ELEC-291-2026/Project2.0/(list of files, cad)

Other CAD files:
FINAL WORKING BUILD FROM OWENS COMPUTER/stm32flash/BO230/BO230.obj
