ELEC-291-2026/Project2.0/schematic.pdf

# DETAILED SCHEMATICS

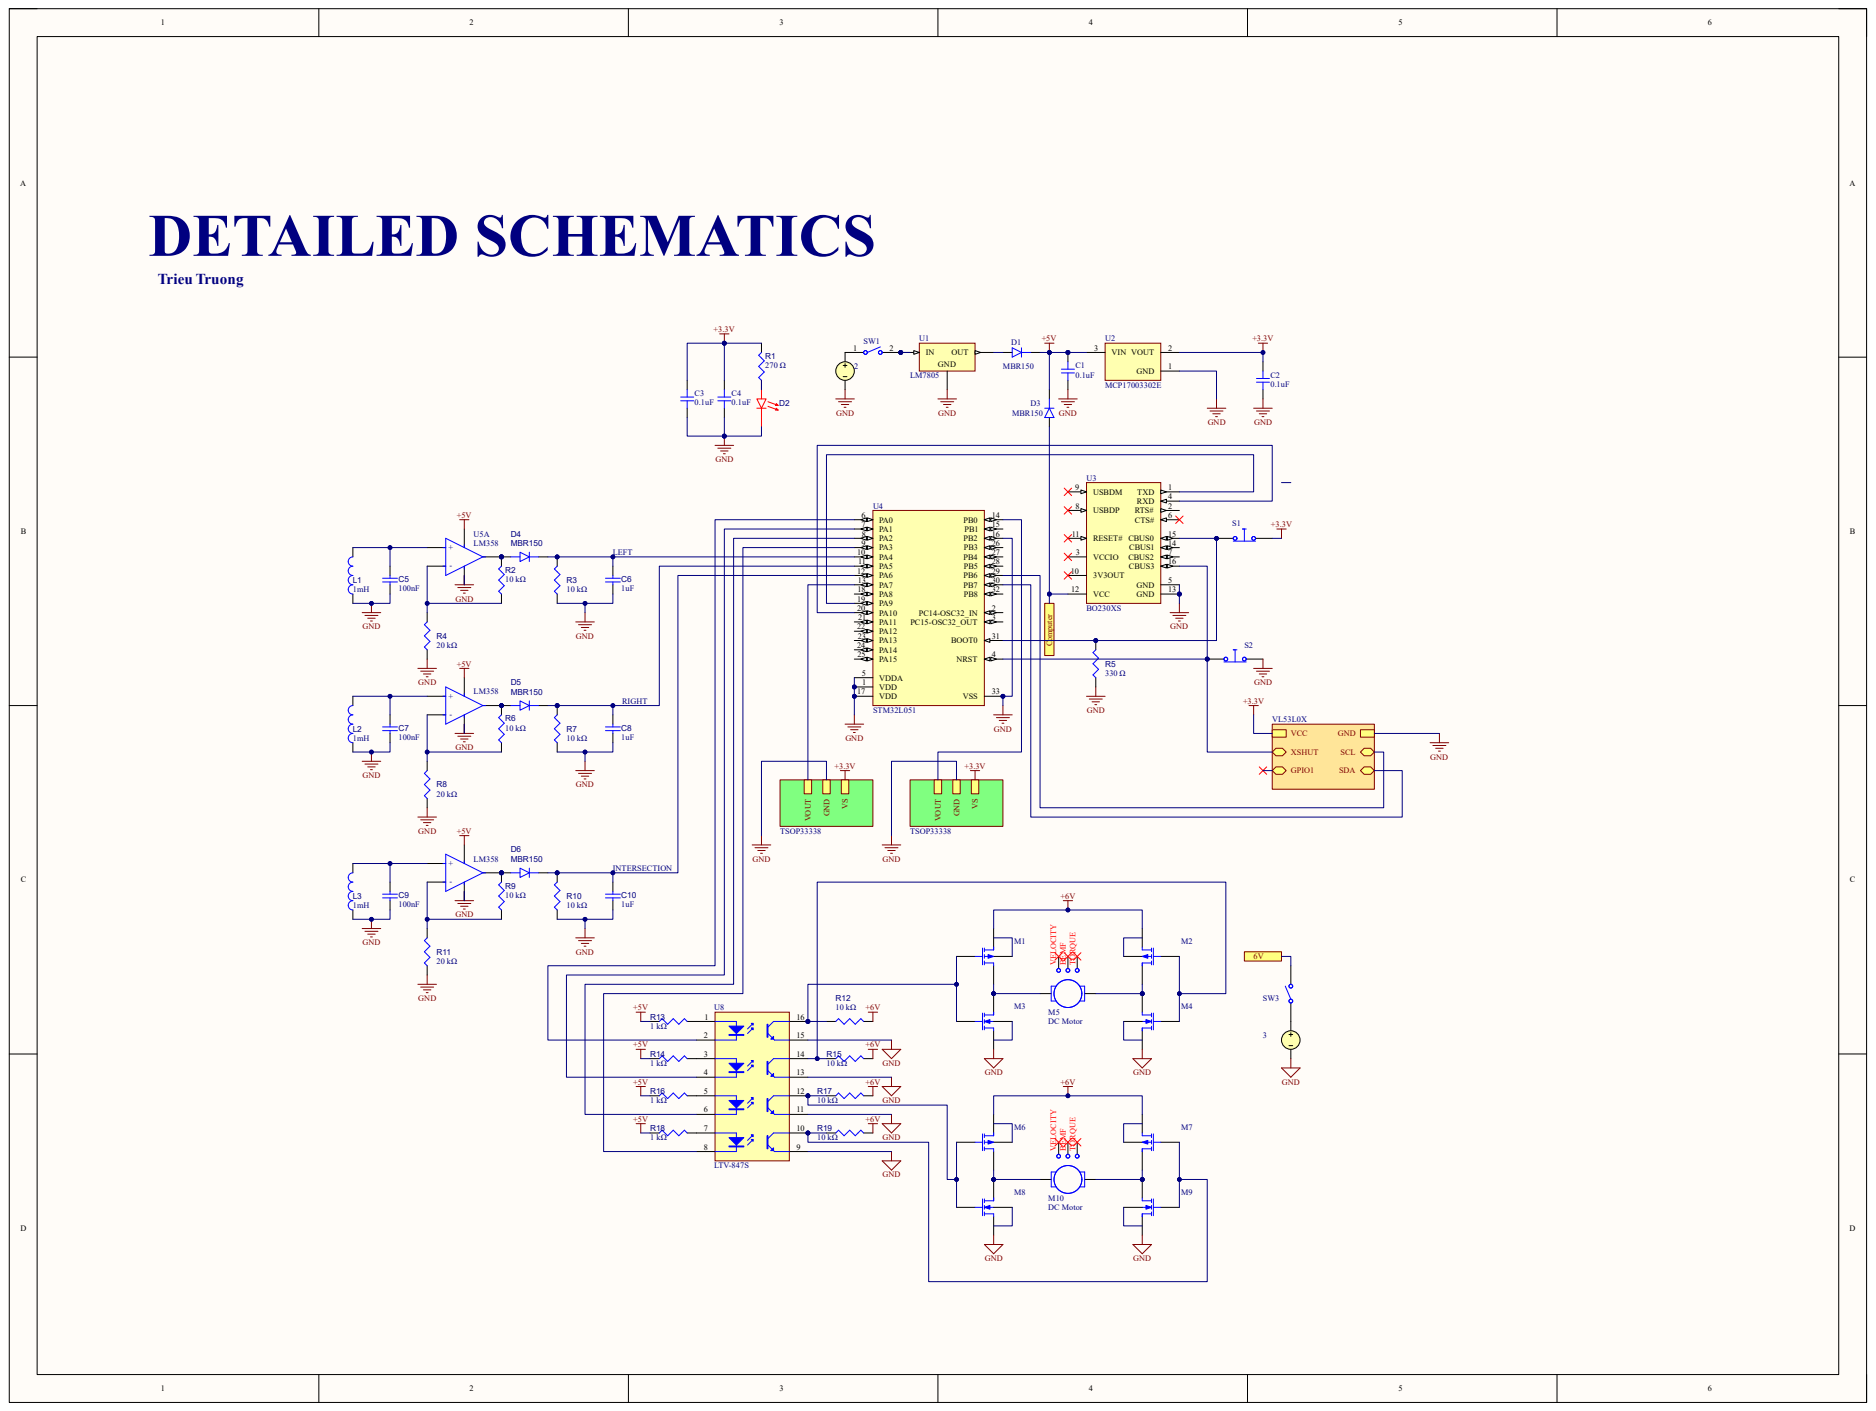
[picture p1: page 1]

GND VS GND VOUT

# H-BRIDGE

# Trieu Truong

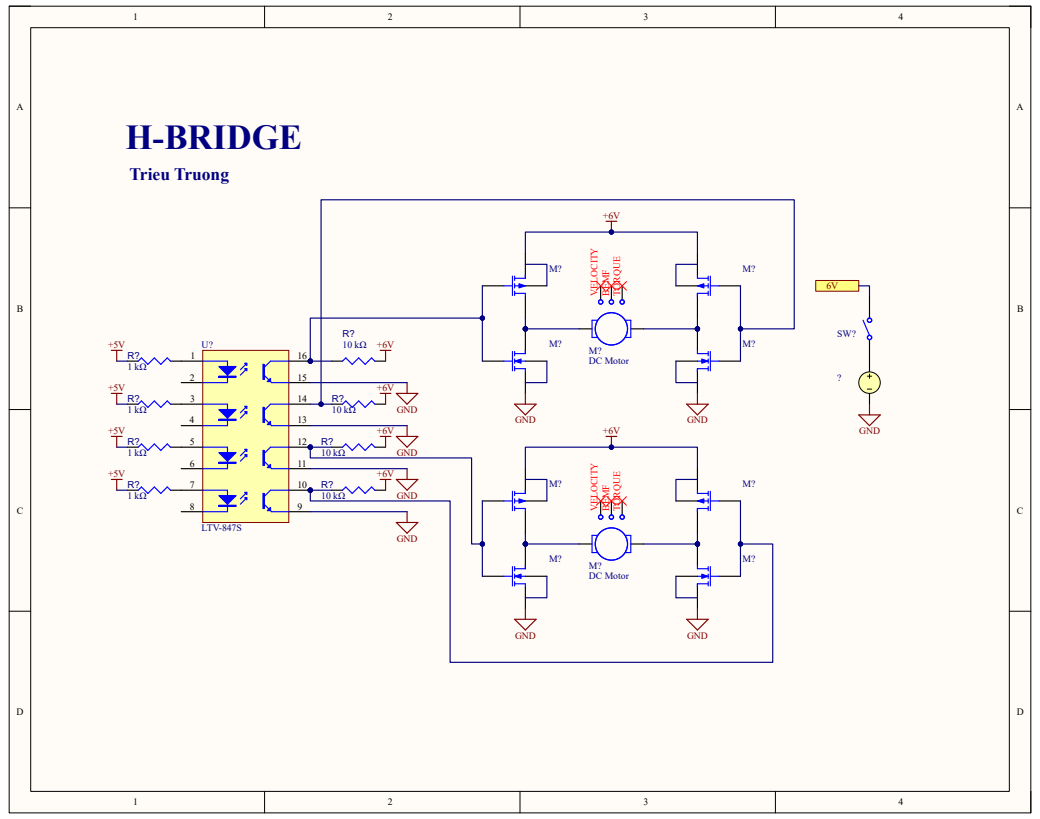
[picture p2: page 2]
LTV-847S; M? DC Motor; GND

M? VELOCITY BEMF TORQUE

# FIELD DETECTOR

# Trieu Truong

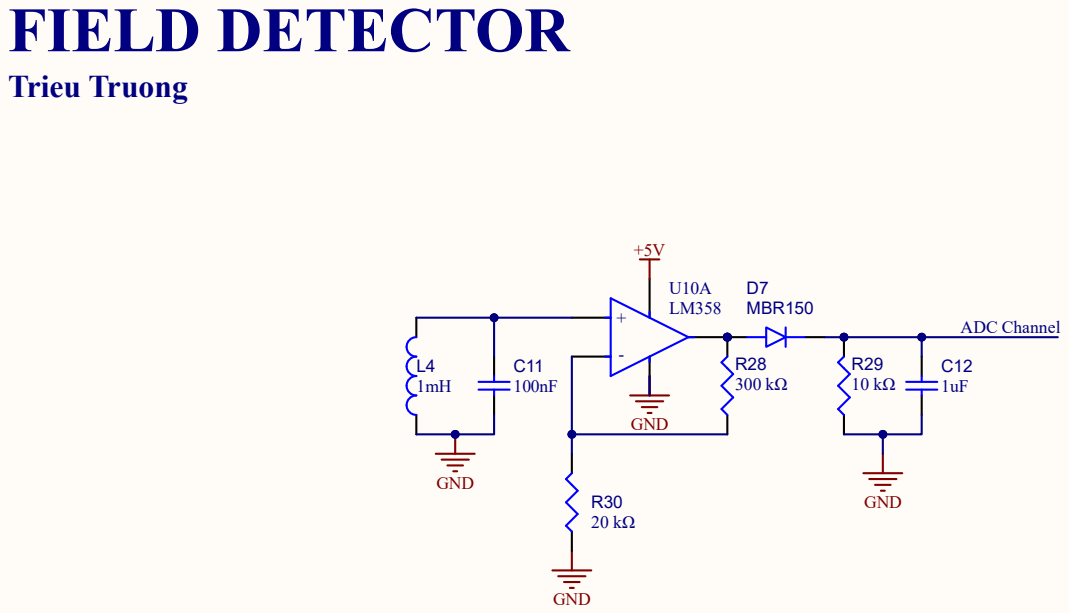
[picture p3: page 3]

# OBSTACLE DETECTOR

# Trieu Truong

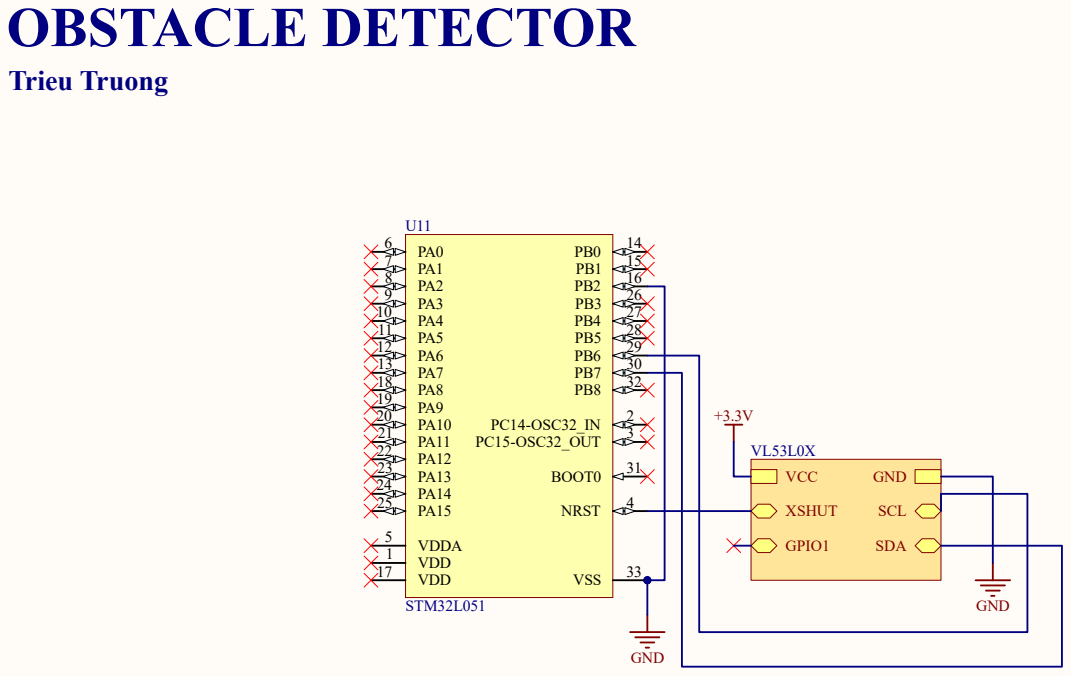
[picture p4: page 4]
VDD 1; VDD 17; PC14-OSC32_IN; PC15-OSC32_OUT; BOOT0; VSS; NRST; VDDA 5; STM32L051; GND; SCL; SDA; VCC; XSHUT; GPIO1

# CONTROLLER

# Trieu Truong

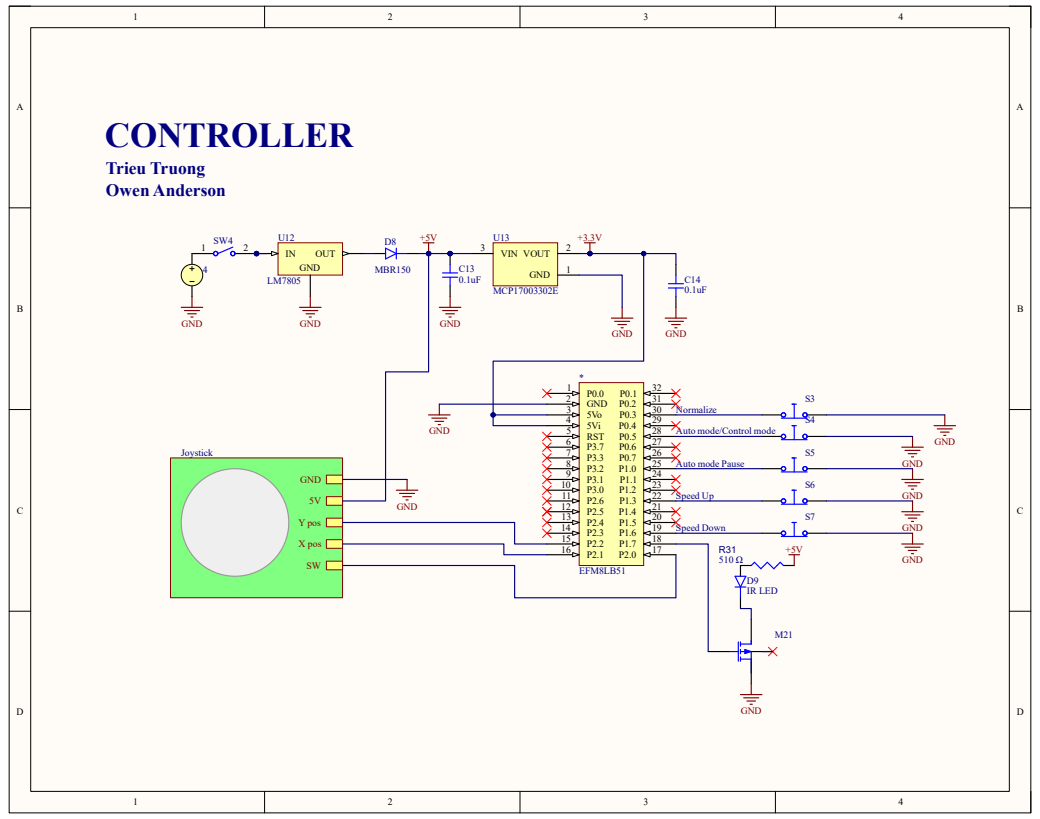
[picture p5: page 5]

Auto mode/Control mode
