ELEC-291-2026/Project2.0/FINAL WORKING BUILD FROM OWENS COMPUTER/main.c

#include "stm32l051xx.h"
#include "robot_auto_mode.h"
#include "collision_detector.h"

#define ADC_CH_LEFT         5
#define ADC_CH_RIGHT        4
#define ADC_CH_INTERSECT    6

int BASE_SPEED = 700;
#define TURN_SPEED          300
#define MAX_PWM             1000
#define KP                  2
#define KD                  3
#define DEADBAND            20

#define ENTRY_SIGNAL        200
#define EXIT_SIGNAL         100
#define INTERSECT_ENTRY     9999
#define INTERSECT_EXIT      100
#define TRACK_ACQUIRE_COUNT 3
#define SEARCH_SLOW_SPEED   200
#define SEARCH_FAST_SPEED   320
#define MIN_FORWARD_SPEED   150
#define MAX_FORWARD_SPEED   480
#define MAX_CORRECTION      160

#define F_CPU 32000000UL

#define LEFT_MOTOR_SIGN     -1
#define RIGHT_MOTOR_SIGN    -1
#define LEFT_MOTOR_TRIM_PCT  125  /* boost left motor by 20% to compensate for weakness */
#define MOTOR_OUTPUT_ACTIVE_LOW 1

#define SOFTWARE_PWM_TICK_HZ 100000UL
#define PWM_PERIOD_COUNTS   1000U

#define LED_SENSOR ((GPIOB->IDR >> 1) & 1U)
#define LED_SENSOR_2 (GPIOB->IDR & 1U)
#define STATUS_LED_GPIO_PORT GPIOA
#define STATUS_LED_PIN       (1U << 8U)

#define LED1_PA15_PIN  (1U << 15U)
#define LED2_PB3_PIN   (1U << 3U)



// LQFP32 pinout
//             ----------
//       VDD -|1       32|- VSS
//      PC14 -|2       31|- BOOT0
//      PC15 -|3       30|- PB7
//      NRST -|4       29|- PB6
//      VDDA -|5       28|- PB5
//       PA0 -|6       27|- PB4
//       PA1 -|7       26|- PB3
//       PA2 -|8       25|- PA15
//       PA3 -|9       24|- PA14
//       PA4 -|10      23|- PA13
//       PA5 -|11      22|- PA12
//       PA6 -|12      21|- PA11
//       PA7 -|13      20|- PA10 (Reserved for RXD)
//       PB0 -|14      19|- PA9  (Reserved for TXD)
//       PB1 -|15      18|- PA8  (LED+1k)
//       VSS -|16      17|- VDD
//             ----------

static int g_last_left_command;
static int g_last_right_command;
static volatile unsigned int g_motor_compare[4];
static volatile unsigned int g_pwm_counter;


static void set_motor_pin(unsigned int bit_mask, int active)
{
#if MOTOR_OUTPUT_ACTIVE_LOW
    if (active)
    {
        GPIOA->ODR &= ~bit_mask;
    }
    else
    {
        GPIOA->ODR |= bit_mask;
    }
#else
    if (active)
    {
        GPIOA->ODR |= bit_mask;
    }
    else
    {
        GPIOA->ODR &= ~bit_mask;
    }
#endif
}

// Add these globals near your other motor globals
static volatile unsigned int g_speaker_toggle_counts = 0;  // half-period in PWM ticks
static volatile unsigned int g_speaker_remaining = 0;       // ticks left to beep
static volatile unsigned int g_speaker_counter = 0;         // counts up to toggle

void speaker_beep(unsigned int frequency_hz, unsigned int duration_ms)
{
    // TIM2 fires at SOFTWARE_PWM_TICK_HZ (100,000 Hz)
    // half-period = ticks per half cycle = 100000 / (2 * freq)
    g_speaker_counter = 0;
    g_speaker_remaining = (SOFTWARE_PWM_TICK_HZ * duration_ms) / 1000U;
    g_speaker_toggle_counts = SOFTWARE_PWM_TICK_HZ / (2U * frequency_hz);
}

void wait_1us(void)
{
    // For SysTick info check the STM32L0xxx Cortex-M0 programming manual
    // Load for 1 microsecond: (SYSCLK_HZ / 1,000,000) - 1
    // At 32MHz, this puts 31 into the LOAD register (32 ticks total)
    SysTick->LOAD = (F_CPU / 1000000UL) - 1UL;  
    SysTick->VAL = 0; 
    SysTick->CTRL = SysTick_CTRL_CLKSOURCE_Msk | SysTick_CTRL_ENABLE_Msk; 
    
    // Wait for the COUNTFLAG (Bit 16) to be set
    while((SysTick->CTRL & SysTick_CTRL_COUNTFLAG_Msk) == 0); 
    
    SysTick->CTRL = 0; // Disable Systick counter
}

void wait_1ms(void)
{
    SysTick->LOAD = (F_CPU / 1000UL) - 1UL;
    SysTick->VAL = 0;
    SysTick->CTRL = 0x5;

    while ((SysTick->CTRL & (1U << 16U)) == 0U)
    {
    }

    SysTick->CTRL = 0;
}

void delayms(unsigned int ms)
{
    while (ms-- > 0U)
    {
        wait_1ms();
    }
}

static void clock_init(void)
{
    RCC->CR |= (1U << 0U);
    while ((RCC->CR & (1U << 2U)) == 0U)
    {
    }

    RCC->CFGR &= ~((0xFUL << 18U) | (0x3U << 22U) | (1U << 16U));
    RCC->CFGR |= (0x1U << 18U) | (0x1U << 22U);

    RCC->CR |= (1U << 24U);
    while ((RCC->CR & (1U << 25U)) == 0U)
    {
    }

    FLASH->ACR |= (1U << 0U);

    RCC->CFGR = (RCC->CFGR & ~0x3U) | 0x3U;
    while ((RCC->CFGR & (0x3U << 2U)) != (0x3U << 2U))
    {
    }
}

static void uart_init(void)
{
    RCC->IOPENR |= (1U << 0U);
    RCC->IOPENR |= (1U << 1U);
    RCC->APB2ENR |= (1U << 14U);

    GPIOA->MODER &= ~(3U << 18U);
    GPIOA->MODER |= (2U << 18U);
    GPIOA->AFR[1] &= ~(0xFU << 4U);
    GPIOA->AFR[1] |= (4U << 4U);

        

    USART1->BRR = 278U;
    USART1->CR1 = (1U << 3U) | (1U << 0U);
}

static void uart_putc(char c)
{
    while ((USART1->ISR & (1U << 7U)) == 0U)
    {
    }

    USART1->TDR = (unsigned char)c;
}

static void uart_puts(const char *s)
{
    while (*s != '\0')
    {
        uart_putc(*s);
        ++s;
    }
}

static void uart_print_int(int val, int width)
{
    char buf[12];
    int len;
    unsigned int uval;

    len = 0;

    if (val < 0)
    {
        uart_putc('-');
        uval = (unsigned int)(-val);
        --width;
    }
    else
    {
        uval = (unsigned int)val;
    }

    if (uval == 0U)
    {
        buf[len++] = '0';
    }
    else
    {
        while (uval > 0U)
        {
            buf[len++] = (char)('0' + (uval % 10U));
            uval /= 10U;
        }
    }

    while (len < width)
    {
        uart_putc(' ');
        --width;
    }

    while (len > 0)
    {
        uart_putc(buf[--len]);
    }
}

static void pwm_init(void)
{
    RCC->IOPENR |= (1U << 0U);
    RCC->APB1ENR |= (1U << 0U);

    GPIOA->MODER &= ~(GPIO_MODER_MODE0 |
        GPIO_MODER_MODE1 |
        GPIO_MODER_MODE2 |
        GPIO_MODER_MODE3);
    GPIOA->MODER |= GPIO_MODER_MODE0_0 |
        GPIO_MODER_MODE1_0 |
        GPIO_MODER_MODE2_0 |
        GPIO_MODER_MODE3_0;

    GPIOA->OTYPER &= ~(BIT0 | BIT1 | BIT2 | BIT3);
    GPIOA->OSPEEDR |= GPIO_OSPEEDER_OSPEED0 |
        GPIO_OSPEEDER_OSPEED1 |
        GPIO_OSPEEDER_OSPEED2 |
        GPIO_OSPEEDER_OSPEED3;
    GPIOA->PUPDR &= ~(GPIO_PUPDR_PUPD0 |
        GPIO_PUPDR_PUPD1 |
        GPIO_PUPDR_PUPD2 |
        GPIO_PUPDR_PUPD3);
        
        
     
	
	
#if MOTOR_OUTPUT_ACTIVE_LOW
    GPIOA->ODR |= BIT0 | BIT1 | BIT2 | BIT3;
#else
    GPIOA->ODR &= ~(BIT0 | BIT1 | BIT2 | BIT3);
#endif

    g_motor_compare[0] = 0U;
    g_motor_compare[1] = 0U;
    g_motor_compare[2] = 0U;
    g_motor_compare[3] = 0U;
    g_pwm_counter = 0U;

    TIM2->PSC = 0U;
    TIM2->ARR = (F_CPU / SOFTWARE_PWM_TICK_HZ) - 1U;
    TIM2->SR = 0U;
    TIM2->DIER = TIM_DIER_UIE;
    TIM2->CR1 = TIM_CR1_ARPE;
    TIM2->EGR = 1U;
    NVIC->ISER[0] |= BIT15;
    TIM2->CR1 |= TIM_CR1_CEN;
    __enable_irq();
}

static unsigned int clamp_command(int command)
{
    unsigned int magnitude;

    if (command < 0)
    {
        magnitude = (unsigned int)(-command);
    }
    else
    {
        magnitude = (unsigned int)command;
    }

    if (magnitude > (unsigned int)MAX_PWM)
    {
        magnitude = (unsigned int)MAX_PWM;
    }

    return magnitude;
}

static unsigned int command_to_compare(int command)
{
    unsigned int compare;
    unsigned int magnitude;

    magnitude = clamp_command(command);
    compare = (magnitude * PWM_PERIOD_COUNTS) / (unsigned int)MAX_PWM;

    if (compare >= PWM_PERIOD_COUNTS)
    {
        compare = PWM_PERIOD_COUNTS - 1U;
    }

    return compare;
}

static void motors_stop(void)
{
    g_motor_compare[0] = 0U;
    g_motor_compare[1] = 0U;
    g_motor_compare[2] = 0U;
    g_motor_compare[3] = 0U;
    set_motor_pin(BIT0, 0);
    set_motor_pin(BIT1, 0);
    set_motor_pin(BIT2, 0);
    set_motor_pin(BIT3, 0);
    g_last_left_command = 0;
    g_last_right_command = 0;
}

static void motors_set(int left, int right)
{
    g_last_left_command = left;
    g_last_right_command = right;

    left = left * LEFT_MOTOR_TRIM_PCT / 100;
    left *= LEFT_MOTOR_SIGN;
    right *= RIGHT_MOTOR_SIGN;

    g_motor_compare[0] = 0U;
    g_motor_compare[1] = 0U;
    g_motor_compare[2] = 0U;
    g_motor_compare[3] = 0U;

    if (left > 0)
    {
        g_motor_compare[0] = command_to_compare(left);
    }
    else if (left < 0)
    {
        g_motor_compare[1] = command_to_compare(left);
    }

    if (right > 0)
    {
        g_motor_compare[2] = command_to_compare(right);
    }
    else if (right < 0)
    {
        g_motor_compare[3] = command_to_compare(right);
    }
}

void TIM2_Handler(void)
{
    TIM2->SR &= ~TIM_SR_UIF;

    set_motor_pin(BIT0, g_motor_compare[0] > g_pwm_counter);
    set_motor_pin(BIT1, g_motor_compare[1] > g_pwm_counter);
    set_motor_pin(BIT2, g_motor_compare[2] > g_pwm_counter);
    set_motor_pin(BIT3, g_motor_compare[3] > g_pwm_counter);

    ++g_pwm_counter;
    if (g_pwm_counter >= PWM_PERIOD_COUNTS)
    {
        g_pwm_counter = 0U;
    }

    // Speaker tone generation
    if (g_speaker_remaining > 0U)
    {
        ++g_speaker_counter;
        if (g_speaker_counter >= g_speaker_toggle_counts)
        {
            GPIOA->ODR ^= (1U << 14); 
            g_speaker_counter = 0U;
        }
        --g_speaker_remaining;
    }
    else
    {
        GPIOA->ODR &= ~(1U << 14);
    }
}


static void adc_init(void)
{
    RCC->IOPENR |= (1U << 0U);
    RCC->APB2ENR |= (1U << 9U);

    GPIOA->MODER |= (3U << 8U) | (3U << 10U) | (3U << 12U);

    ADC1->CFGR2 |= (1U << 30U);

    if ((ADC1->CR & (1U << 0U)) != 0U)
    {
        ADC1->CR |= (1U << 1U);
        while ((ADC1->CR & (1U << 0U)) != 0U)
        {
        }
    }

    ADC1->CR |= (1U << 28U);
    delayms(1U);

    ADC1->CR |= (1U << 31U);
    while ((ADC1->CR & (1U << 31U)) != 0U)
    {
    }

    ADC1->SMPR = 0x5U;
    ADC1->CFGR1 = 0U;
    ADC1->CR |= (1U << 0U);
    while ((ADC1->ISR & (1U << 0U)) == 0U)
    {
    }
}

static int adc_read(int channel)
{
    int sum;
    int i;

    sum = 0;
    ADC1->CHSELR = (1U << channel);

    for (i = 0; i < 4; ++i)
    {
        ADC1->CR |= (1U << 2U);
        while ((ADC1->ISR & (1U << 2U)) == 0U)
        {
        }
        sum += (int)(ADC1->DR & 0xFFFU);
    }

    return sum / 4;
}

static const char *movement_name(int left, int right)
{
    if (left == 0 && right == 0)
    {
        return "STOP";
    }

    if (left > 0 && right > 0)
    {
        if (left == right)
        {
            return "FORWARD";
        }

        if (left > right)
        {
            return "VEER_RIGHT";
        }

        return "VEER_LEFT";
    }

    if (left < 0 && right < 0)
    {
        if (left == right)
        {
            return "REVERSE";
        }

        if (left < right)
        {
            return "REV_RIGHT";
        }

        return "REV_LEFT";
    }

    if (left < 0 && right > 0)
    {
        return "TURN_LEFT";
    }

    if (left > 0 && right < 0)
    {
        return "TURN_RIGHT";
    }

    if (left == 0)
    {
        if (right > 0)
        {
            return "PIVOT_LEFT";
        }

        return "PIVOT_RIGHT";
    }

    if (left > 0)
    {
        return "ARC_RIGHT";
    }

    return "ARC_LEFT";
}

static void control(int x, int y)
{
	//we convert to new system where left is controlled by x+y, and right by x-y
	int scaled_x = x*999/1000/2;
	int scaled_y = y*999/1000;
	
	int left = (scaled_y+scaled_x);
	int right = (scaled_y-scaled_x);
	
	motors_set(left, right);
}

static void timer22_init(void)
{
    RCC->APB2ENR |= RCC_APB2ENR_TIM22EN; // Enable TIM22 clock
    
    TIM22->PSC = 31;                     // Prescaler: 32MHz / (31 + 1) = 1MHz
    TIM22->ARR = 0xFFFF;                 // Auto-reload to max (16-bit)
    TIM22->CR1 &= ~TIM_CR1_CEN;          // Keep it off until needed
}

/* Bridge called by robot_auto_mode.c to drive the physical motors. */
void hbridge_motor_apply(const motor_command_t *command)
{
    motors_set(command->left_command, command->right_command);
}

static void led_flash(unsigned int pin_bit, unsigned int times)
{
    unsigned int i;
    for (i = 0; i < times; i++)
    {
        GPIOB->ODR |=  pin_bit;
        delayms(60);
        GPIOB->ODR &= ~pin_bit;
        delayms(60);
    }
}


void swap_paths(path_context_t *ctx)
{
	ctx->selected_path = (path_id_t)((ctx->selected_path + 1) % 3);
	ctx->intersection_count = 0;
    ctx->intersection_active = 0;

    led_flash((1U<<4U), ctx->selected_path+1);
}

void main(void)
{
    field_data_t sensors;
    path_context_t context;
    collision_detector_t collision;
    int tof_ok;
    unsigned int i;
    unsigned int loop;

    field_sensor_reset(&sensors);

    g_last_left_command = 0;
    g_last_right_command = 0;
    loop = 0U;

    clock_init();
    uart_init();
    pwm_init();
    adc_init();
    motors_stop();
    timer22_init();

    robot_auto_mode_init(&context, PATH_ID_1);
    tof_ok = collision_detector_init(&collision);

    delayms(500U);
    uart_puts("Robot starting up...\r\n");
    uart_puts(tof_ok ? "ToF init OK\r\n" : "ToF init FAILED\r\n");
    uart_puts("--- RAW ADC DUMP (no filtering) ---\r\n");

    for (i = 0U; i < 20U; ++i)
    {
        uart_puts("L=");
        uart_print_int(adc_read(ADC_CH_LEFT), 4);
        uart_puts("  R=");
        uart_print_int(adc_read(ADC_CH_RIGHT), 4);
        uart_puts("  IX=");
        uart_print_int(adc_read(ADC_CH_INTERSECT), 4);
        uart_puts("\r\n");
        delayms(100U);
    }
    
    
    // Enable Clock for GPIOA (already done in pwm_init, but safe to keep)
	RCC->IOPENR |= (1U << 0U);
	// Enable GPIOB Clock 
	RCC->IOPENR |= (1U << 1U); 
	
	// PB1 and PB0 setup: Set to Input Mode (00)
	GPIOB->MODER &= ~((3U << 2) | (3U << 0));
	
	// --- ADD THIS SECTION ---
	// Enable Internal Pull-up resistors for PB0 and PB1
	// PUPDR bits: 01 = Pull-up, 10 = Pull-down, 00 = None
	GPIOB->PUPDR &= ~((3U << 2) | (3U << 0)); // Clear bits
	GPIOB->PUPDR |=  ((1U << 2) | (1U << 0)); // Set to 01 (Pull-up)
	
	// Status LED on PA8, leaving PB6/PB7 dedicated to the VL53L0X I2C bus
    GPIOA->MODER &= ~(3U << 16U);
    GPIOA->MODER |=  (1U << 16U);
    GPIOA->ODR   &= ~STATUS_LED_PIN;
    
	// Set PA15 to Output Mode (01)
	GPIOA->MODER &= ~(3U << 30U); // Clear bits 30-31
	GPIOA->MODER |=  (1U << 30U); // Set bit 30 for Output
	GPIOA->ODR   &= ~LED1_PA15_PIN; // Start with LED off
	
	// Set PB3 to Output Mode (01)
	GPIOB->MODER &= ~(3U << 6U);  // Clear bits 6-7
	GPIOB->MODER |=  (1U << 6U);  // Set bit 6 for Output
	GPIOB->ODR   &= ~LED2_PB3_PIN;  // Start with LED off

	//Led on PB4
    GPIOB->MODER &= ~(3U << 8U);   // clear bits 8-9 (PB4)
    GPIOB->MODER |=  (1U << 8U);   // output mode for PB4
    GPIOB->ODR   &= ~(1U << 4U);   // start low
	
	//SPEAKER
	GPIOA->MODER &= ~(3U << 28U); // Clear bits 28 and 29
	GPIOA->MODER |=  (1U << 28U); // Set bit 28 (Output Mode)
	
	// Optional: Set Speed to Medium/High for a cleaner square wave
	GPIOA->OSPEEDR |= (2U << 28U);

    uart_puts("--- END DUMP, starting warmup ---\r\n");

    for (i = 0U; i < 64U; ++i)
    {
        field_sensor_update(&sensors,
            adc_read(ADC_CH_LEFT),
            adc_read(ADC_CH_RIGHT),
            adc_read(ADC_CH_INTERSECT));
        delayms(2U);
    }

    uart_puts("Warmup done. Entering main loop.\r\n");

    int auto_mode = 0;
    int counterMS = 0;
	float normalized[2] = {0,0};
	float translated_v[2] = {0,0};
	int auto_counter = 0;
	int auto_stop_flag = 0;
	int collision_counter = 0;
	int backwards_beep = 0;
	
	// control var
	int counterNormalize = 6;
    
    while (1)
    {
    	start:;
        if(LED_SENSOR_2 == 0 || LED_SENSOR == 0)
	    {
	        counterMS = 0;
	        TIM22->CNT = 0;           // Reset counter to zero
	        TIM22->CR1 |= TIM_CR1_CEN; // Start TIM22
	        
	        // Wait here while the sensor is LOW (the pulse duration)
	        while(LED_SENSOR_2 == 0 || LED_SENSOR == 0)
	        {

	        }
	        
	        TIM22->CR1 &= ~TIM_CR1_CEN; // Stop TIM22
	        counterMS = TIM22->CNT;     // Capture the EXACT microsecond count
		
	        if(counterMS <= 2000) 
	        {
	        	goto end;
	        }
	        else if(counterMS <= 8000)
	        {
	        	translated_v[0] = counterMS - normalized[0];
	        	
	        	
	        	if(translated_v[0] >=1200 || translated_v[0] <= -1200)
	        		translated_v[0] = 0;
	        	else if(translated_v[0] >=900)
	        		translated_v[0] = 1000;
	        	else if(translated_v[0] <= -900)
	        		translated_v[0] = -1000;
	        	else if(translated_v[0] <= 150 && translated_v[0] >= -150)
	        		translated_v[0] = 0;
	        		
	        }
	        else if(counterMS <=  18000)
	        {
	        	translated_v[1] = counterMS - normalized[1];
	        	
	        	
	        	if(translated_v[1] >=1200 || translated_v[1] <= -1200)
	        		translated_v[1] = 0;
	        	else if(translated_v[1] >=900)
	        		translated_v[1] = 1000;
	        	else if(translated_v[1] <= -900)
	        		translated_v[1] = -1000;
	        	else if(translated_v[1] <= 150 && translated_v[1] >= -150)
	        		translated_v[1] = 0;
	        		
	        	
	        }
	        
	        else if(counterMS <=  23000)
	    	{
	    		counterNormalize = 3;
				speaker_beep(1000, 200);
	    	}
	    	
	    	else if(counterMS <=  27500)
	    	{
	    		
	    		auto_mode = !auto_mode;
	    		if(auto_mode)
	    			led_flash((1U<<4U), 1);
	    		else 
	    			counterNormalize = 3;
	    		speaker_beep(1000, 200);
	    	}
	    	else if(counterMS <= 32000)
	    	{
	    		if(auto_mode)
                	swap_paths(&context);
                else if(!auto_mode)
	    		{
		    		speaker_beep(500, 200);
		    		delayms(100);
		    		speaker_beep(1000, 300);
		    		delayms(100);
		    		speaker_beep(500, 300);
		    	}
            }
	    	else if(counterMS <=  38000)
	    	{
	    		auto_stop_flag = !auto_stop_flag;
	    	}
			else if(counterMS <= 45000)
			{
				if(auto_mode)
				{
					if(BASE_SPEED < 999)
						BASE_SPEED += 50;
				}
                speaker_beep(1000, 200);
            }
			else if(counterMS <= 51000)
			{
				if(auto_mode)
				{
					if(BASE_SPEED > 500)
						BASE_SPEED -= 50;
				}
                speaker_beep(1000, 200);
            }
	        
	        if(counterNormalize > 0)
	    	{
	    		counterNormalize--;
	    		if(counterMS <= 6000)
					normalized[0] = counterMS;
				else if(counterMS <= 18000)
					normalized[1] = counterMS;
	    	}

			uart_puts("\n\r x: ");
	        uart_print_int((int)translated_v[0], 5);
	        uart_puts("   y: ");
	        uart_print_int((int)translated_v[1], 5);
			uart_puts("   ms:");
	        uart_print_int(counterMS, 7);
	        uart_puts("   automode:");
	        uart_print_int(auto_mode, 2);
	        
	        if (auto_mode == 0)
	        {
	        	int cx = (int)translated_v[0];
	        	int cy = (int)translated_v[1];
	        	if (tof_ok && collision.obstacle_detected && cy > 0)
	        	{
	        		cy = 0;
	        		
	        		uart_puts("\n\rYESYEYSYESY");
	        	}
	            control(cx, cy);
	            // turns on both LEDS
	            GPIOA->ODR |= LED1_PA15_PIN;
				GPIOB->ODR |= LED2_PB3_PIN;
	            if(cy < 0)
	            {
	            	// turns off both LEDS
	            	GPIOA->ODR &= ~LED1_PA15_PIN;
					GPIOB->ODR &= ~LED2_PB3_PIN;
	            	backwards_beep++;
	            	if(backwards_beep >= 4)
	            	{
	            		speaker_beep(500, 100);
	            		backwards_beep = 0;
	            	}
	            }
	            if(cx > 0)
	            {
	            	// turns on right LED
	            	GPIOB->ODR |= LED2_PB3_PIN;
	            	// turns off left LED
	            	GPIOA->ODR &= ~LED1_PA15_PIN;
	            }
	            else if(cx < 0)
	            {
	            	// turns on left LED
	            	GPIOA->ODR |= LED1_PA15_PIN;
	            	// turns off right LED
	            	
GPIOB->ODR &= ~LED2_PB3_PIN;
	            }
	            
	            
	            

	        }
	        
	        
	        
	    	end:;
	    	
	    }


	
 	    if (auto_mode == 1)
        {
            field_sensor_update(&sensors,
	            adc_read(ADC_CH_LEFT),
	            adc_read(ADC_CH_RIGHT),
	            adc_read(ADC_CH_INTERSECT));

            if ((loop % 5U) == 0U)
            {
            	/**
                uart_puts("mode=AUTO | L r=");
                uart_print_int(sensors.left_raw, 4);
                uart_puts(" s=");
                uart_print_int(sensors.left_signal, 4);
                uart_puts(" d=");
                uart_print_int(sensors.left_detected, 1);
                uart_puts(" | R r=");
                uart_print_int(sensors.right_raw, 4);
                uart_puts(" s=");
                uart_print_int(sensors.right_signal, 4);
                uart_puts(" d=");
                uart_print_int(sensors.right_detected, 1);
                uart_puts(" | IX r=");
                uart_print_int(sensors.intersection_raw, 4);
                uart_puts(" | dir=");
                uart_puts(movement_name(g_last_left_command, g_last_right_command));
                uart_puts(" lc=");
                uart_print_int(g_last_left_command, 4);
                uart_puts(" rc=");
                uart_print_int(g_last_right_command, 4);
                uart_puts(" ix=");
                uart_print_int(context.intersection_count, 1);
                uart_puts("\r\n");
                **/
            }
        }
        else if ((loop % 5U) == 0U)
        {
        	/**
            uart_puts("mode=REMOTE | x=");
            uart_print_int((int)translated_v[0], 4);
            uart_puts(" y=");
            uart_print_int((int)translated_v[1], 4);
            uart_puts(" | dir=");
            uart_puts(movement_name(g_last_left_command, g_last_right_command));
            uart_puts(" lc=");
            uart_print_int(g_last_left_command, 4);
            uart_puts(" rc=");
            uart_print_int(g_last_right_command, 4);
            uart_puts("\r\n");
            **/
        }

	    ++loop;
		
		
		collision_counter++;
		if (auto_mode == 0)
        {
			if (tof_ok && collision_counter >= 35000)
			{
				collision_counter = 0;
				collision_detector_update(&collision);
			}
		}
        else if (auto_mode == 1 && auto_stop_flag == 0)
        {
        	if (tof_ok && collision_counter >= 3000)
			{
				collision_counter = 0;
				collision_detector_update(&collision);
			}
        	if (tof_ok && collision.obstacle_detected)
        	{
        		motors_stop();
        	}
        	else
        	{
	        	auto_counter++;
	        	if(auto_counter >= 335)
	        	{
	            	robot_auto_mode_step(&sensors, &context);
	            	auto_counter = 0;
	            }
	        }
        }
        else
        {
        	motors_stop();
        }
		
	    
	        
	    
	}
}
