ELEC-291-2026/Project2.0/FINAL WORKING BUILD FROM OWENS COMPUTER/hbridge_motor.h

#ifndef HBRIDGE_MOTOR_H
#define HBRIDGE_MOTOR_H

#include "robot_auto_mode.h"

void hbridge_motor_init(void);
void hbridge_motor_stop_all(void);
void hbridge_motor_apply(const motor_command_t *command);
motor_command_t hbridge_motor_get_last_command(void);

#endif
