ELEC-291-2026/Project2.0/(commit log)

2026-03-09 Revise README for ELEC291 Coin Picking Robot
    Updated project title and added detailed sections including project overview, system architecture, hardware requirements, subsystems, wireless communication, and operating modes for the Coin Picking Robot project.
2026-03-16 adc/fake pins rn
2026-03-23 motor test
2026-03-23 makefile changes
    [BO230.obj]
2026-03-24 auto mode update
    [BO230.obj]
2026-03-26 Real Pins + Collision detection Integration
    [collision_detector.c, collision_detector.h, collision_detector_config.h, field_sensor_adc_config.h, main.c, main.h]
2026-03-27 Final Update with Normalize button
2026-03-27 motor testing
2026-03-27 motor turn direction
2026-03-27 pin update
2026-03-27 motor driving code changes
2026-03-27 motor changes
2026-03-30 Wire robot_auto_mode into auto_mode; implement EFM8-style bang-bang following
    - Replaced inline duplicate state machine in main.c with calls to
    robot_auto_mode_init() and robot_auto_mode_step()
    - Added hbridge_motor_apply() bridge in main.c
    - Added robot_auto_mode.o to Makefile
    - Implemented EFM8-style bang-bang wire following in run_follow_controller:
    raw ADC diff with hard steer threshold instead of proportional control
    - intersection_detected() now uses raw ADC threshold directly
    - Lost state keeps driving instead of stopping (matches EFM8 behaviour)
    - Added robot_auto_mode_set_path() for future IR path switching
    - Swapped ADC_CH_LEFT/RIGHT to match physical sensor wiring
    - Tuned: BAS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
    [field_sensor_adc_config.h, main.c, robot_auto_mode.c, robot_auto_mode.h]
2026-03-30 Fix intersection detection and timed turns
    - Show intersection_raw in UART debug instead of signal
    - Lower INTERSECTION_THRESHOLD to 100 for calibration
    - Stop at intersection then execute time-based turn (700ms)
    instead of sensor-gated spin — robot was exiting turn early
    as center sensor dropped immediately on pivot
    [main.c, robot_auto_mode.c]
2026-03-30 Add VL53L0X obstacle detection and Wemos telemetry dashboard
    - Fix NACKCF bug in I2C read path (was aborting valid reads)
    - Replace HAL macros with bare-metal register writes
    - Add async UART TX ring buffer (USART1, 9600 baud, IRQ-driven)
    - Stream telemetry CSV over PA9 to Wemos D1 Mini every ~1s
    - Wemos parses CSV and serves live dashboard over WiFi (team5291)
    - Robot stops when obstacle detected within 200mm
    [collision_detector.c, collision_detector_config.h, main.c, robot_auto_mode.c, robot_auto_mode.h]
2026-03-31 Add files via upload
    Need to provide your own stm32flash
2026-04-01 Add BUTTON_4 functionality and clean up comments
2026-04-01 Refactor includes and add led_flash function
2026-04-01 fixed obstacle in control mode
    [main.c]
2026-04-01 Motor correction, obstacle stuff
    [collision_detector_config.h, main.c, robot_auto_mode.c]
2026-04-11 Update schematics
