ELEC-291-2026/Project2.0/(notices)

Notices in the files:
FINAL WORKING BUILD FROM OWENS COMPUTER/stm32flash/i2c.c:
modify it under the terms of the GNU General Public License
